clpalmer/avrusb500v3/Hardware/avrusb500v2/atmel_stk500_v2/README

These are the original specifications from Atmel. The software
was written from scratch using those documents:
AVR068.zip
stk500_spec_AVR068-revC.pdf
stk500_spec_AVR069.pdf

This is a trace log from a real stk500:
CommunicationLogFromRealSTK500.txt
