clpalmer/avrusb500v3/Hardware/avr500v3.pdf

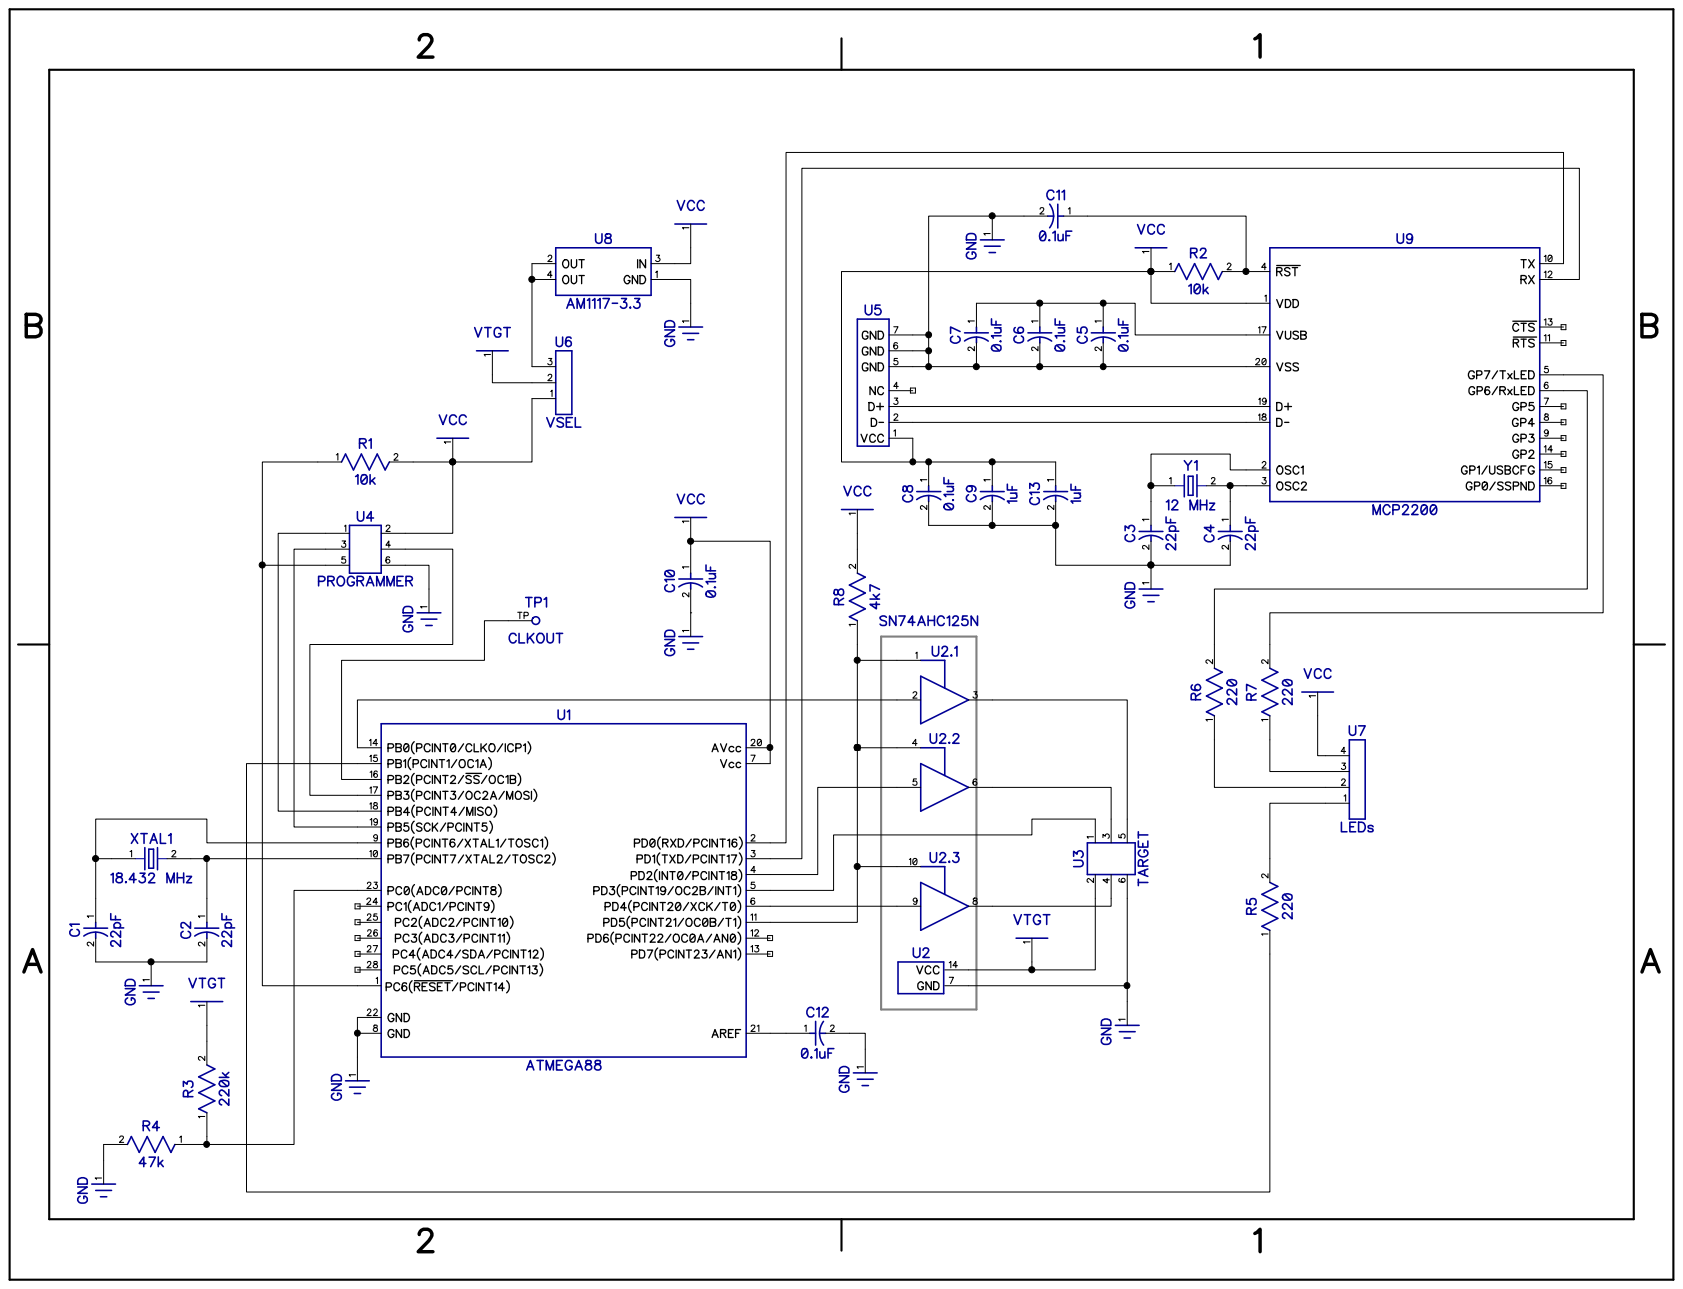
[picture p1: page 1]
