clpalmer/avrusb500v3/Hardware/avrusb500v2/avrusb500v2-2011.pdf

# AvrUsb500 Version 2, usb key

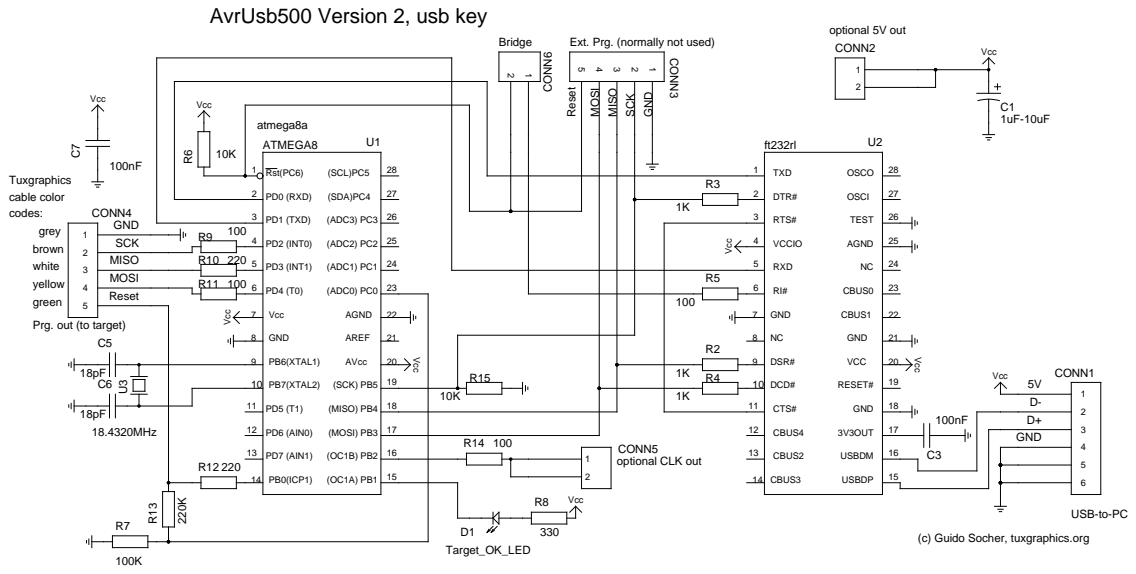
[picture p2: page 1]

Ext. Prg. (normally not used)

MOSI | R5

Prg. out (to target)

R12 220 | 18 (MISO) PB4 | 10K | 1K

(c) Guido Socher, tuxgraphics.org
