clpalmer/avrusb500v3/(list of files, drawings)

Other design files:
Hardware/avr500v3.dch
Hardware/avr500v3.dip
