clpalmer/avrusb500v3/(commit log)

2018-03-22 Added hardware specs and original avrusv500v2 files
    [avr500v2.dch, avr500v2.dip]
2018-03-22 Updated schematics to v3
    [avr500v2.dip, avr500v3.dch, avr500v3.dip]
